tommyrohmann/Steam-Engine/1.5x1 Inch 3 Cylidner/Engine Screenshots and Drawings/IMG_2193.jpg

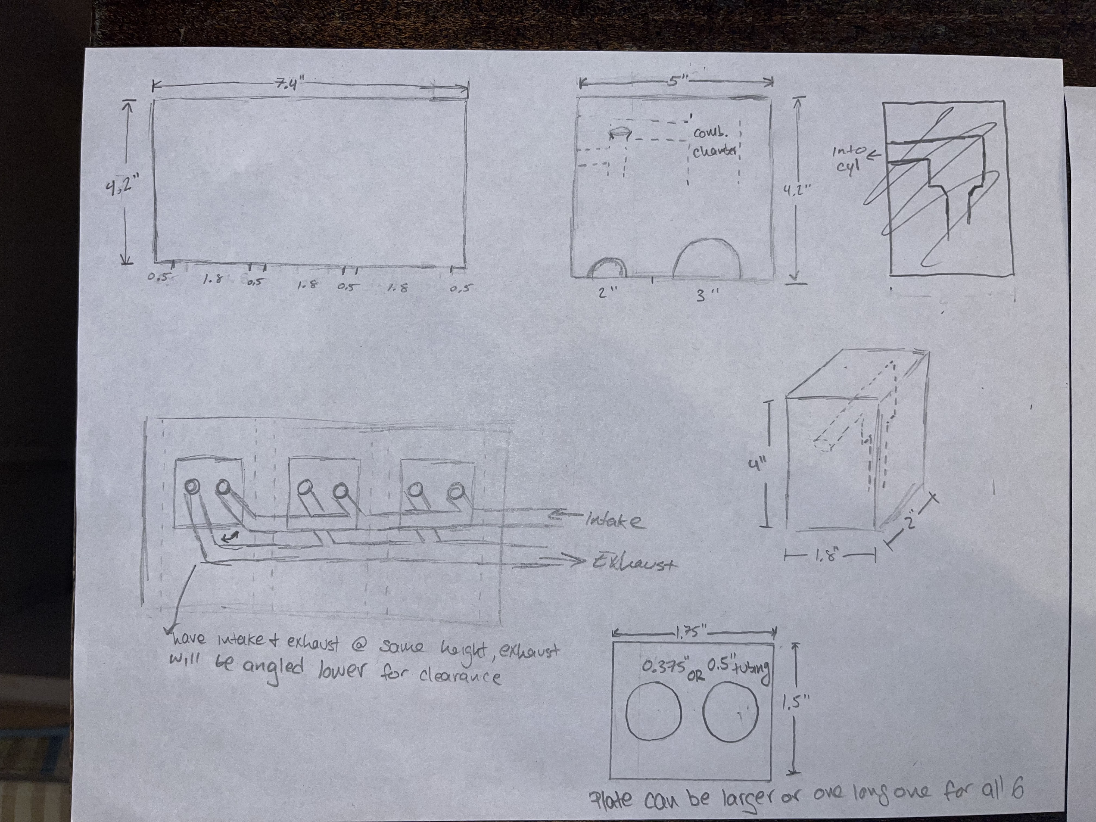
1.5x1 Inch 3 Cylidner/Engine Screenshots and Drawings/IMG_2193.jpg
