tommyrohmann/Steam-Engine/Les Proper Steam Engine/steamboatbookcover_sm.pdf

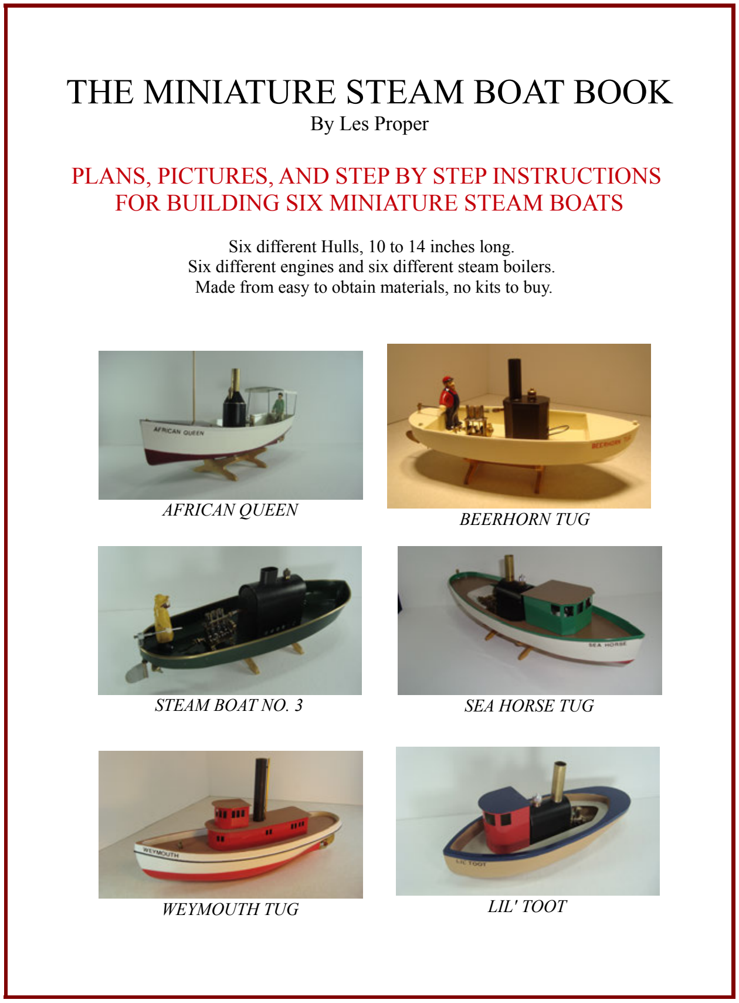
[picture p8: figure]
THE MINIATURE STEAM BOAT BOOK; By Les Proper; FOR BUILDING SIX MINIATURE STEAM BOATS; AFRICAN QUEEN; BEERHORN TUG; LIL' TOOT; STEAM BOAT NO. 3; WEYMOUTH TUG; SEA HORSE TUG

## PLANS, PICTURES, AND STEP BY STEP INSTRUCTIONS

Six different Hulls, 10 to 14 inches long.
Six different engines and six different steam boilers. Made from easy to obtain materials, no kits to buy.

# TABLE OF CONTENTS

PAGE
INTRODUCTION | 1 - 4

SECTION 1 - AFRICAN QUEEN
African Queen Building Instructions | 1 - 21
African Queen Hull and Deck | AQ - 1
Single Cylinder Double Acting Steam Engine | AQ - 2
African Queen Steam Boiler | AQ - 3
African Queen Details | AQ - 4
African Queen Photos | AQ - 5

SECTION 2 - BEERHORN TUG
Beerhorn Tug Building Instructions | 1 - 21
Beerhorn Tug Hull and Deck | BT - 1
Twin Cylinder Single Acting Steam Engine | BT - 2
Beerhorn Tug Steam Boiler | BT - 3&4
Beerhorn Tug Details | BT - 5
Beerhorn Tug Photos | BT - 6

SECTION 3 - STEAM BOAT NO. 3
Steam Boat No. 3 Building Instructions | 1 - 21
Steam Boat No. 3 Hull and Deck | SB3 - 1
Three Cylinder Single Acting Steam Engine | SB3 - 2
Horizontal Boiler No. 1 | SB3 - 3&4
Steam Boat No. 3 Details | SB3 - 5
Steam Boat No. 3 Photos | SB3 - 6

SECTION 4 - SEA HORSE TUG
Sea Horse Tug Building Instructions | 1 - 20
Sea Horse Tug Hull | SHT - 1
V - 4 Cylinder Steam Engine | SHT - 2
Horizontal Boiler No. 2 | SHT - 3&4
Sea Horse Tug Details | SHT - 5&6
Sea Horse Tug Deck and Wheelhouse | SHT - 7
Sea Horse Tug Photos | SHT - 8

SECTION 5 - WEYMOUTH TUG
Weymouth Tug Building Instructions | 1 - 25
Weymouth Tug Hull | WT - 1&2
Weymouth Tug Deck and Superstructure | WT - 3
Twin Cylinder Double Acting Steam Engine | WT - 4
Weymouth Tug Boiler | WT - 5,6&7
Weymouth Tug Details | WT - 8
Weymouth Tug Photos | WT - 9

SECTION 6 - LIL' TOOT TUG
Lil' Toot Tug Building Instructions | 1 - 21
Lil' Toot Tug Hull, Deck, and Wheelhouse | LT - 1
One Cylinder Single Acting Steam Engine | LT - 2
Horizontal Boiler No. 3 | LT - 3&4
Lil' Toot Tug Details | LT - 4
Lil' Toot Tug Photos | LT - 5
