tommyrohmann/Steam-Engine/1.5x1 Inch 3 Cylidner/Engine Screenshots and Drawings/PXL_20230312_021201561.jpg

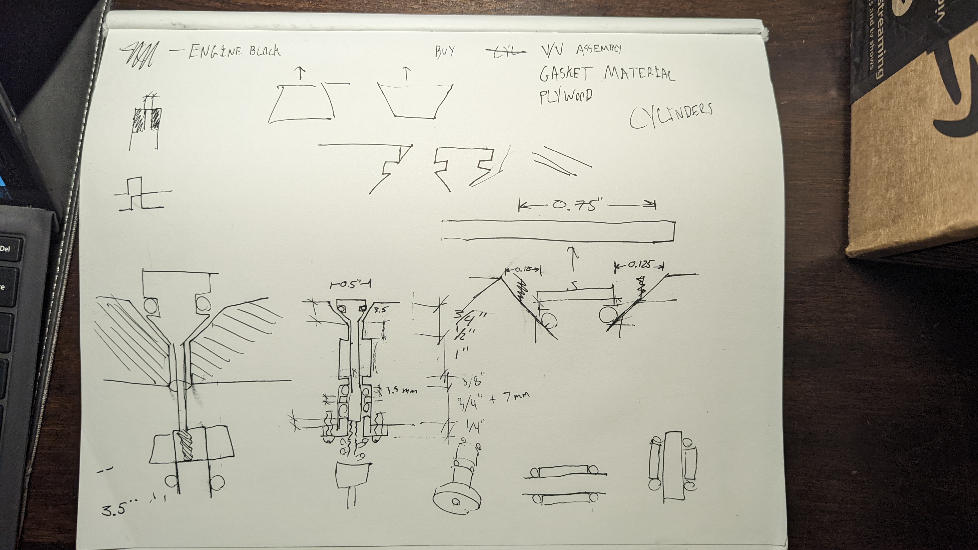
1.5x1 Inch 3 Cylidner/Engine Screenshots and Drawings/PXL_20230312_021201561.jpg
