tommyrohmann/Steam-Engine/Les Proper Steam Engine/Parts List/Les Proper Steam Engine Material List and Cost Analysis.xlsb.xlsx

Sheet: Parts List
Column1 | Column2 | Column3 | Column4
1 | CYLINDER | 9/32" BRASS TUBE
2 | CYLINDER HEAD | FREE CUTTING BRASS ROD
3 | VALVE TUBE | 1/8" BRASS TUBE
4 | BRASS TOP | 0.03" x 1/2" BRASS FLAT BAR
5 | BRASS BASE | 0.03" x 3/4" BRASS FLAT BAR
6 | FRAME POST | 3/32" FREE CUTTING BRASS ROD
7 | INLET MANIFOLD | 3/32" BRASS TUBE
8 | FLYWHEEL | 1/2" FREE CUTTING BRASS ROD
9 | CRANKSHAFT | 5/64" & 3/8" DRILL ROD
10 | 0-80 STAINLESS HEX HEAD AND PHILLIPS HEAD BOLTS
11 | PISTON | FREE CUTTING BRASS ROD | MACHINE TO FIT
12 | VALVE | FREE CUTTING BRASS ROD | MACHINE TO FIT
13 | CONNECTING ROD | 1/32" x 3/32" BRASS FLAT BAR
14 | MAIN BEARING | FREE CUTTING BRASS ROD
15 | VALVE ROD | 1/32" BRASS ROD
16 | ECCENTRIC | 1/4" FREE CUTTING BRASS ROD

Sheet: Sheet1
 | Resource Videos
 | https://www.youtube.com/watch?v=QCbsiK79rfI |  |  | # of Engines | 1 |  |  |  | Retailer: McMaster-Carr |  |  | Cost after shipping and tax
 | https://www.youtube.com/watch?v=bR_tIMWJvpI&list=PLPgGN1PUfGZnEqCRSK7it8fPnHxa9Ix1D |  |  | Length lost due to cutting | 0.125 |  |  |  | Tot. Cost | $206.20 |  | 166.33
 |  |  |  | Safety Factor | 1.1 | 10% |  |  | Cost/Person | $206.20 |  | 166.33
 |  |  |  | Cost Per Person
 |  |  | Component/Machining Chars |  |  | Purchase Chars
# | Component on Engine | Part | len/qty needed per part | # of Parts Needed | QTY Plus Cutting Length and Safety Factor | Len/qty of unit bought | Cost/Unit | QTY to Buy | Cost of Material | Link | Notes
1 | CYLINDER | 9/32" BRASS TUBE | 0.55 | 1 | 0.7425 | 12 | $2.76 | 1 | $2.76 | Ultra-Formable 260 Brass, Round Tube, 1 Foot Long, 0.014" Wall Thickness, 9/32" OD | McMaster-Carr (https://www.mcmaster.com/8859K25/)
2 | CYLINDER HEAD | FREE CUTTING BRASS ROD (Stock) | 0.15 | 1 | 0.3025 | 1 |  | 1 | $0.00
3 | VALVE TUBE | 1/8" ID BRASS TUBE | 0.68 | 1 | 0.8855 | 12 | $2.30 | 1 | $2.30 | https://www.mcmaster.com/8859K21/
4 | BRASS TOP | 0.03" x 1/2" BRASS FLAT BAR | 0.71 | 1 | 0.9185 | 12 | $2.31 | 1 | $2.31 | https://www.mcmaster.com/8859K83/
5 | BRASS BASE | 0.03" x 3/4" BRASS FLAT BAR | 0.71 | 1 | 0.9185 | 12 | $3.37 | 1 | $3.37 | Ultra-Formable 260 Brass, Strip, 3/4" x 12", 0.0320" Thick | McMaster-Carr (https://www.mcmaster.com/8859K84/)
6 | FRAME POST | 3/32" FREE CUTTING BRASS ROD | 0.73 | 4 | 3.762 | 12 | $1.42 | 1 | $1.42 | Ultra-Formable 260 Brass, 1 Foot Long Rod, 3/32" Diameter | McMaster-Carr (https://www.mcmaster.com/8859K52/)
7 | INLET MANIFOLD | 3/32" BRASS TUBE | 0.25 | 1 | 0.4125 | 36 | $3.49 | 1 | $3.49 | https://www.mcmaster.com/8859K18/
8 | FLYWHEEL | 1/2" FREE CUTTING BRASS ROD | 0.21 | 1 | 0.3685 | 1 |  | 1 | $0.00
9 | CRANKSHAFT | 5/64" DRILL ROD | 1 | 1 | 1.2375 | 24 | $36.61 | 1 | $36.61 | Rotary Shaft, 316 Stainless Steel, 5/64" Diameter, 24" Long | McMaster-Carr (https://www.mcmaster.com/1263K28/)
9 | Crankshaft | 3/8" DRILL ROD | 0.12 | 2 | 0.539 | 12 | $6.52 | 1 | $6.52 | Rotary Shaft, 316 Stainless Steel, 5/64" Diameter, 24" Long | McMaster-Carr (https://www.mcmaster.com/1263K28/)
10 | 0-80 STAINLESS HEX HEAD AND PHILLIPS HEAD BOLTS | ASSEMBLY AND SET SCREWS | 1 | 9 | 11.1375 | 100 | $10.67 | 1 | $10.67 | https://www.mcmaster.com/91781A055/
11 | PISTON | FREE CUTTING BRASS ROD | 0.35 | 1 | 0.5225 | 1 | 0 | 1 | $0.00
12 | VALVE | FREE CUTTING BRASS ROD | 0.78 | 1 | 0.9955 | 1 | 0 | 1 | $0.00
13 | CONNECTING ROD | 1/32" x 3/32" BRASS FLAT BAR | 0.82 | 1 | 1.0395 | 12 | $1.32 | 1 | $1.32 | https://www.mcmaster.com/8859K82/
14 | MAIN BEARING | FREE CUTTING BRASS ROD | 0 | 2 | 0.275 | 1 | 0 | 1 | $0.00
15 | VALVE ROD | 1/32" BRASS ROD | 1 | 1 | 1.2375 | 60 | $2.39 | 1 | $2.39 | https://www.mcmaster.com/8859K481/
16 | ECCENTRIC | 1/4" FREE CUTTING BRASS ROD | 0 | 1 | 0.1375 | 1 | 0 | 1 | $0.00
 | SUM LENGTH OF MACHINE BRASS STOCK (HIGHLIGHTED ORANGE) | 1/2" BRASS STOCK | 2.6015 | 1 | 2.99915 | 36 | $38.77 | 1 | $38.77 | Formable Easy-to-Machine 353 Brass Rod, 1/2" Diameter | McMaster-Carr (https://www.mcmaster.com/8313K14/)
 |  | Required Tools
 |  | 0-80 Tap |  |  |  |  | $6.76 | 4 | $27.04 | https://www.mcmaster.com/25995A114/
 |  | Drill Bit Set | 1 |  |  |  | 39.99 | 1 | $39.99 | https://www.amazon.com/gp/product/B07QNPBTKY/ref=ppx_yo_dt_b_asin_title_o04_s00?ie=UTF8&psc=1
 |  | Silver Solder |  |  |  |  |  |  | $0.00 | https://www.amazon.com/Oatay-Plumbing-Solder-solder-flux/dp/B000FK743G
 |  |  |  |  |  |  | 19.75 | 1 | $19.75 | https://www.amazon.com/Oatay-Plumbing-Solder-solder-flux/dp/B000FK743G?s=hi
 |  |  |  |  |  |  |  |  | $0.00 | https://www.amazon.com/gp/product/B07Z41KQ36/ref=sw_img_1?smid=AYAOXGJC4GQOY&psc=1
 |  | 5mm End Mill |  |  |  |  |  |  | $0.00 | https://www.amazon.com/1pc-Flutes-Carbide-Square-Mill/dp/B09VFFDLS7?pid=iKz2KQj&s=industrial
 |  |  |  |  |  |  | 7.49 | 1 | $7.49 | https://www.amazon.com/gp/product/B000936R1O/ref=sw_img_1?smid=ATVPDKIKX0DER&psc=1
