tommyrohmann/Steam-Engine/1.5x1 Inch 3 Cylidner/Steam Engine Purchase 1/Steam Engine Purchase 1.png

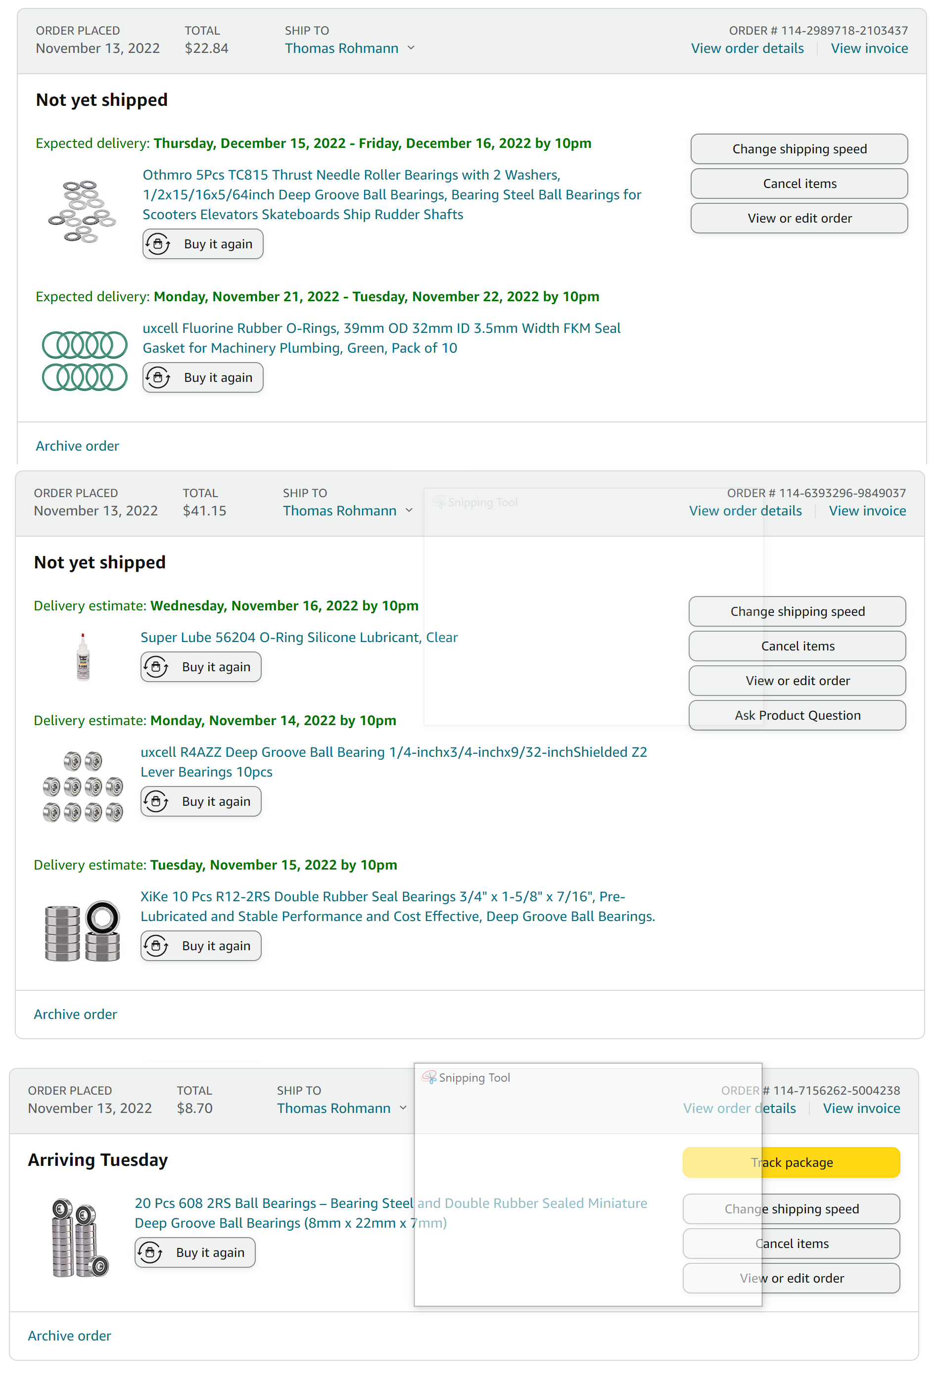
1.5x1 Inch 3 Cylidner/Steam Engine Purchase 1/Steam Engine Purchase 1.png
