tommyrohmann/Steam-Engine/1.5x1 Inch 3 Cylidner/Cast and Assembled V5/Cutting Jigs/C.Crank on Crankshaft Cutting Jig.stl

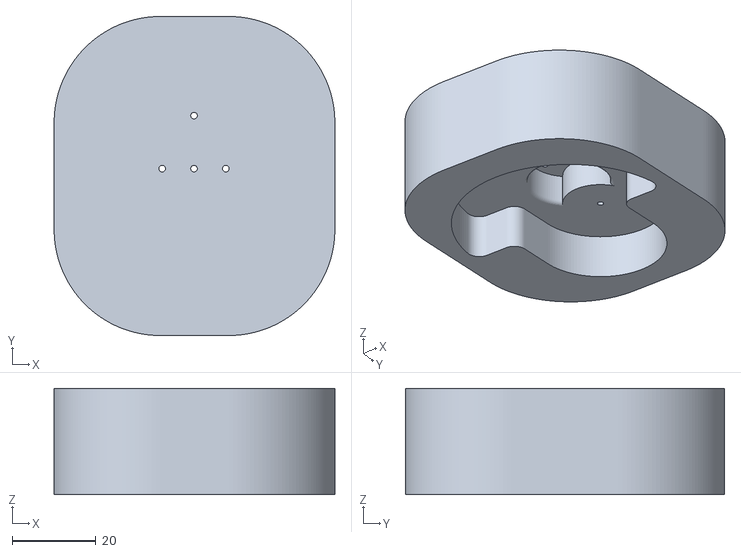
[picture p13: CAD file, 2023-02-10]
1.5x1 Inch 3 Cylidner/Cast and Assembled V5/Cutting Jigs/C.Crank on Crankshaft Cutting Jig.stl
67.2 x 76.4 x 25.4
