tommyrohmann/Steam-Engine/1.5x1 Inch 3 Cylidner/Cast and Assembled V5/STLs for 3d Prints/Piston Head Stock Cast Image.stl

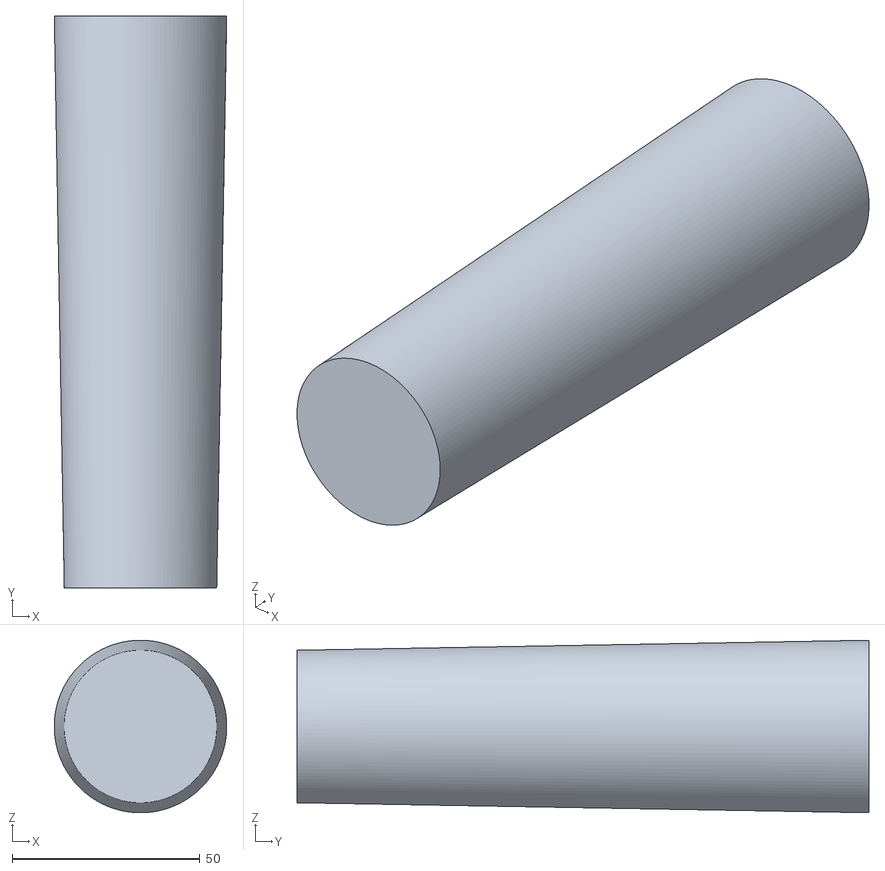
[picture p15: CAD file, 2023-03-14]
1.5x1 Inch 3 Cylidner/Cast and Assembled V5/STLs for 3d Prints/Piston Head Stock Cast Image.stl
46.0 x 152.4 x 46.0
