tommyrohmann/Steam-Engine/Les Proper Steam Engine/CAD/Cutting Jig/Cutting Jig.stl

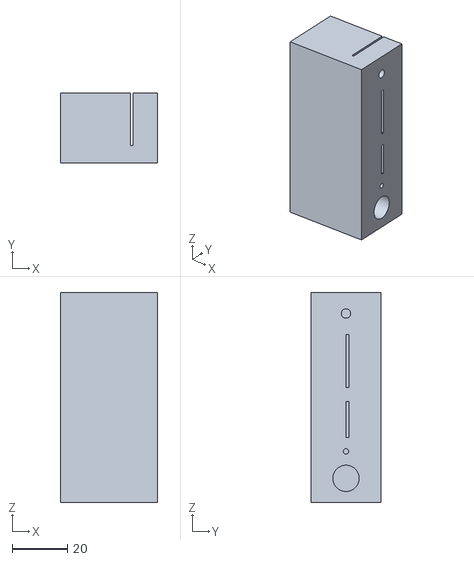
[picture p16: CAD file, 2023-04-16]
Les Proper Steam Engine/CAD/Cutting Jig/Cutting Jig.stl
35.1 x 25.4 x 76.2
