tommyrohmann/Steam-Engine/1.5x1 Inch 3 Cylidner/Cast and Assembled V5/Cutting Jigs/C.Connecting Rod Cutting Jig.stl

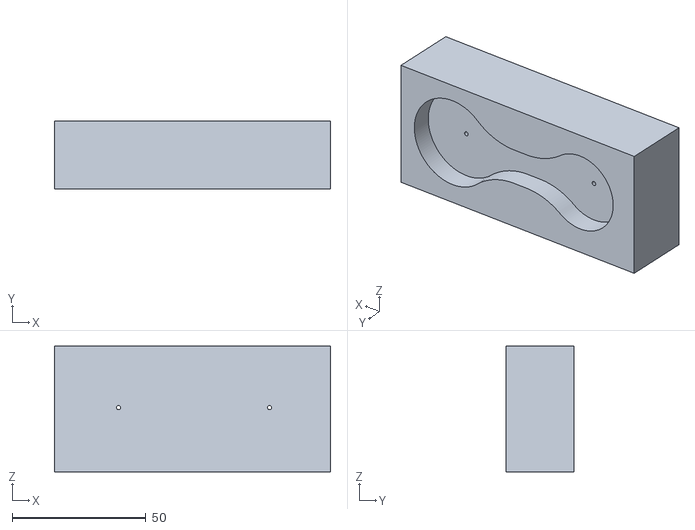
[picture p17: CAD file, 2023-02-09]
1.5x1 Inch 3 Cylidner/Cast and Assembled V5/Cutting Jigs/C.Connecting Rod Cutting Jig.stl
103.3 x 25.4 x 47.1
