tommyrohmann/Steam-Engine/1.5x1 Inch 3 Cylidner/Cast and Assembled V5/Mock up Parts/C.Crank Connect Shaft .44 Inch.stl

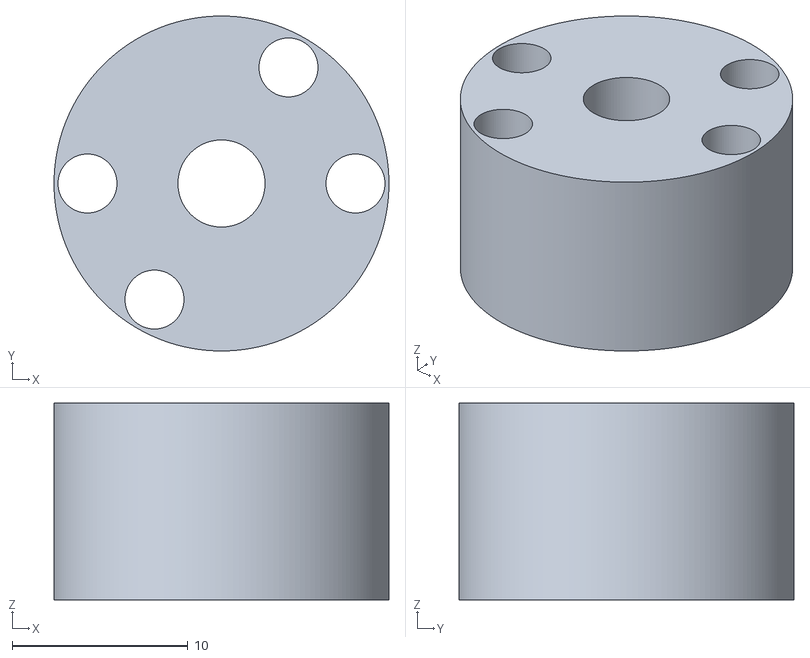
[picture p18: CAD file, 2023-02-17]
1.5x1 Inch 3 Cylidner/Cast and Assembled V5/Mock up Parts/C.Crank Connect Shaft .44 Inch.stl
19.0 x 19.0 x 11.2
