tommyrohmann/Steam-Engine/1.5x1 Inch 3 Cylidner/Cast and Assembled V5/STLs for 3d Prints/Cylinder Block Cast Image.stl

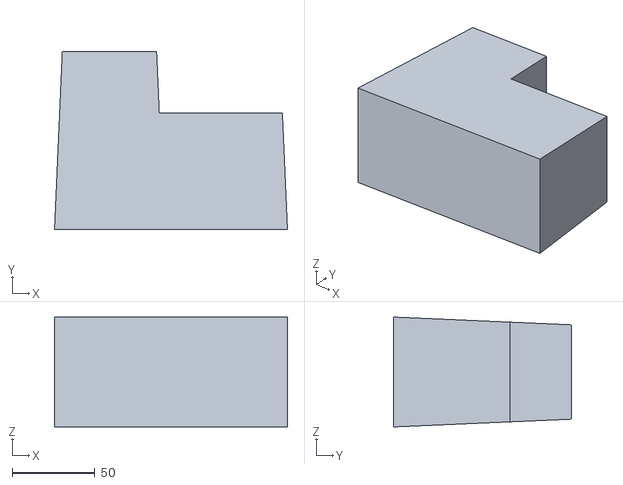
[picture p19: CAD file, 2023-03-14]
1.5x1 Inch 3 Cylidner/Cast and Assembled V5/STLs for 3d Prints/Cylinder Block Cast Image.stl
141.1 x 108.0 x 66.6
