tommyrohmann/Steam-Engine/1.5x1 Inch 3 Cylidner/Cast and Assembled V5/Cutting Jigs/C.Crank Connect Shaft Cutting Jig.stl

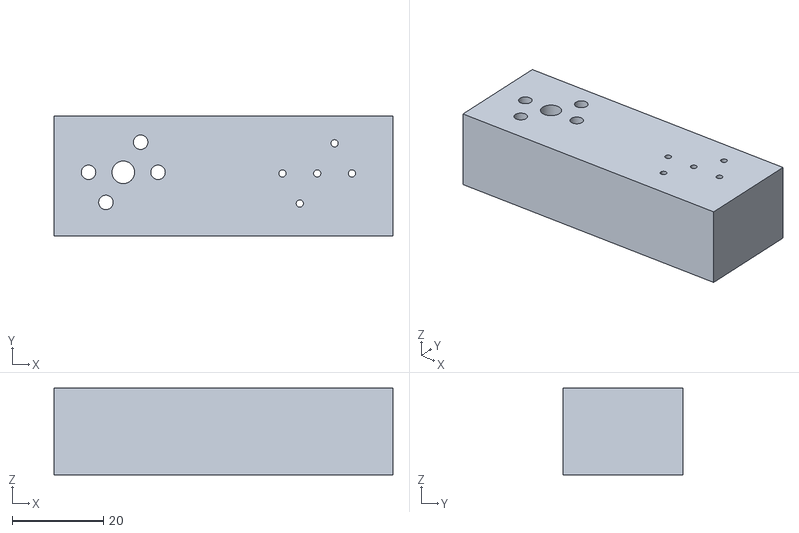
[picture p20: CAD file, 2023-02-09]
1.5x1 Inch 3 Cylidner/Cast and Assembled V5/Cutting Jigs/C.Crank Connect Shaft Cutting Jig.stl
74.3 x 26.3 x 19.0
