tommyrohmann/Steam-Engine/1.5x1 Inch 3 Cylidner/Old/2 inch Design V2/3d Prints/Crank on Crankshaft 2.stl

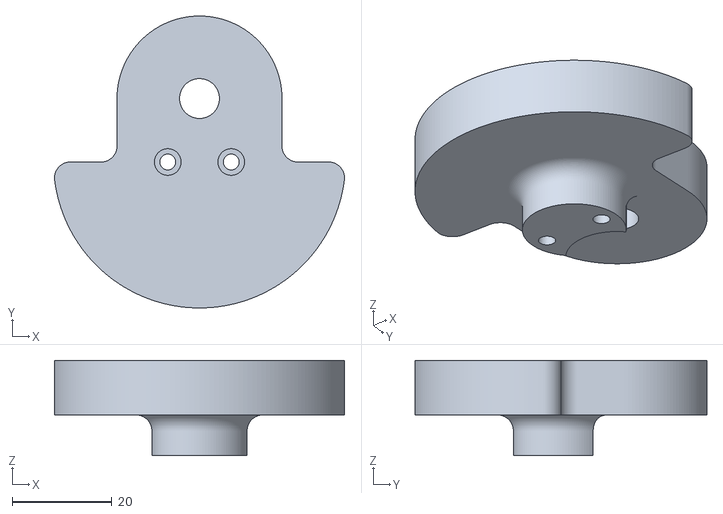
[picture p21: CAD file, 2022-12-22, an earlier design]
1.5x1 Inch 3 Cylidner/Old/2 inch Design V2/3d Prints/Crank on Crankshaft 2.stl
58.0 x 58.4 x 19.0
