tommyrohmann/Steam-Engine/(list of files, cad)

Other CAD files:
Les Proper Steam Engine/Drawings/Engine Assembly Final.dwg
1.5x1 Inch 3 Cylidner/Cast and Assembled V5/CrankShaft Center Cut Drawing.dwg
1.5x1 Inch 3 Cylidner/Cast and Assembled V5/Drawings for Machining/PDFs/C.Crank Connect Shaft.dwg
Les Proper Steam Engine/Drawings/OldVersions/Engine Assembly.0011.dwg
Les Proper Steam Engine/Drawings/OldVersions/Engine Assembly Final.0004.dwg
Les Proper Steam Engine/Drawings/OldVersions/Cylinder Assembly Drawing.0001.dwg
1.5x1 Inch 3 Cylidner/Cast and Assembled V5/Drawings for Machining/PDFs/OldVersions/C.Crank Connect Shaft.0001.dwg
1.5x1 Inch 3 Cylidner/Cast and Assembled V5/OldVersions/CrankShaft Center Cut Drawing.0001.dwg
1.5x1 Inch 3 Cylidner/2 Inch V3/Connecting Rod Bearing.ipt
1.5x1 Inch 3 Cylidner/2 Inch V3/Connecting Rod.iam
1.5x1 Inch 3 Cylidner/2 Inch V3/Crank on Crankshaft.ipt
1.5x1 Inch 3 Cylidner/2 Inch V3/CrankShaft Main Bearing.ipt
1.5x1 Inch 3 Cylidner/2 Inch V3/Crankshaft Subassembly.iam
1.5x1 Inch 3 Cylidner/2 Inch V3/Crankshaft.ipt
1.5x1 Inch 3 Cylidner/2 Inch V3/Frame Sides.ipt
1.5x1 Inch 3 Cylidner/2 Inch V3/Head Cylinder and Frame Subassembly.iam
1.5x1 Inch 3 Cylidner/2 Inch V3/Piston 2.ipt
1.5x1 Inch 3 Cylidner/2 Inch V3/Piston Subassembly.iam
1.5x1 Inch 3 Cylidner/Cast and Assembled V5/A.Crankshaft Subassembly.iam
1.5x1 Inch 3 Cylidner/Cast and Assembled V5/A.Piston Subassembly.iam
1.5x1 Inch 3 Cylidner/Cast and Assembled V5/C.Connecting Rod Bearing.ipt
1.5x1 Inch 3 Cylidner/Cast and Assembled V5/C.Connecting Rod.ipt
1.5x1 Inch 3 Cylidner/Cast and Assembled V5/C.Crank Connect Shaft.ipt
1.5x1 Inch 3 Cylidner/Cast and Assembled V5/C.Crank on Crankshaft.ipt
1.5x1 Inch 3 Cylidner/Cast and Assembled V5/C.Crankshaft Main Bearing.ipt
1.5x1 Inch 3 Cylidner/Cast and Assembled V5/Cast Images/C.Crank on Crankshaft Cast Image.ipt
1.5x1 Inch 3 Cylidner/Cast and Assembled V5/Cast Images/Connecting Rod Cast Image.ipt
1.5x1 Inch 3 Cylidner/Cast and Assembled V5/Cast Images/Cylinder Block Cast Image.ipt
1.5x1 Inch 3 Cylidner/Cast and Assembled V5/Cast Images/OldVersions/C.Crank on Crankshaft Cast Image.0001.ipt
1.5x1 Inch 3 Cylidner/Cast and Assembled V5/Cast Images/OldVersions/E.Engine Block Bottom Cast Image Left.0001.ipt
1.5x1 Inch 3 Cylidner/Cast and Assembled V5/Cast Images/OldVersions/E.Engine Block Bottom Cast Image Right.0001.ipt
1.5x1 Inch 3 Cylidner/Cast and Assembled V5/Cast Images/OldVersions/E.Engine Block Bottom Cast Image.0001.ipt
1.5x1 Inch 3 Cylidner/Cast and Assembled V5/Cast Images/OldVersions/E.Engine Block Top Cast Image Right.0001.ipt
1.5x1 Inch 3 Cylidner/Cast and Assembled V5/Cast Images/OldVersions/E.Engine Block Top Cast Image.0001.ipt
1.5x1 Inch 3 Cylidner/Cast and Assembled V5/Cast Images/Piston Head Stock Cast Image.ipt
1.5x1 Inch 3 Cylidner/Cast and Assembled V5/Cutting Jigs/C.Connecting Rod Cutting Jig.ipt
1.5x1 Inch 3 Cylidner/Cast and Assembled V5/Cutting Jigs/C.Crank Connect Shaft Cutting Jig.ipt
1.5x1 Inch 3 Cylidner/Cast and Assembled V5/Cutting Jigs/C.Crank on Crankshaft Cutting Jig 2.ipt
1.5x1 Inch 3 Cylidner/Cast and Assembled V5/Cutting Jigs/C.Crank on Crankshaft Cutting Jig.dwg
1.5x1 Inch 3 Cylidner/Cast and Assembled V5/Cutting Jigs/C.Crank on Crankshaft Cutting Jig.ipt
1.5x1 Inch 3 Cylidner/Cast and Assembled V5/Cutting Jigs/OldVersions/C.Connecting Rod Cutting Jig.0001.ipt
1.5x1 Inch 3 Cylidner/Cast and Assembled V5/Cutting Jigs/OldVersions/C.Crank Connect Shaft Cutting Jig.0001.ipt
1.5x1 Inch 3 Cylidner/Cast and Assembled V5/Cutting Jigs/OldVersions/C.Crank on Crankshaft Cutting Jig.0004.ipt
1.5x1 Inch 3 Cylidner/Cast and Assembled V5/E.Bearing Holder Top.ipt
1.5x1 Inch 3 Cylidner/Cast and Assembled V5/E.Cylinder Block.ipt
1.5x1 Inch 3 Cylidner/Cast and Assembled V5/E.Engine Head Gasket.ipt
1.5x1 Inch 3 Cylidner/Cast and Assembled V5/E.Engine Head Top.ipt
1.5x1 Inch 3 Cylidner/Cast and Assembled V5/Engine Assembly.iam
1.5x1 Inch 3 Cylidner/Cast and Assembled V5/OldVersions/A.Piston Subassembly.0001.iam
1.5x1 Inch 3 Cylidner/Cast and Assembled V5/OldVersions/C.Connecting Rod Bearing.0002.ipt
1.5x1 Inch 3 Cylidner/Cast and Assembled V5/OldVersions/C.Connecting Rod.0005.ipt
1.5x1 Inch 3 Cylidner/Cast and Assembled V5/OldVersions/C.Crank Connect Shaft.0013.ipt
1.5x1 Inch 3 Cylidner/Cast and Assembled V5/OldVersions/C.Crank on Crankshaft.0011.ipt
1.5x1 Inch 3 Cylidner/Cast and Assembled V5/OldVersions/C.Crankshaft Main Bearing.0002.ipt
1.5x1 Inch 3 Cylidner/Cast and Assembled V5/OldVersions/Cam Shaft Test.0002.ipt
1.5x1 Inch 3 Cylidner/Cast and Assembled V5/OldVersions/Camshaft Bearing.0001.ipt
1.5x1 Inch 3 Cylidner/Cast and Assembled V5/OldVersions/Connecting Rod Bearing.0001.ipt
1.5x1 Inch 3 Cylidner/Cast and Assembled V5/OldVersions/Connecting Rod Cast Image.0001.ipt
1.5x1 Inch 3 Cylidner/Cast and Assembled V5/OldVersions/Connecting Rod.0001.iam
1.5x1 Inch 3 Cylidner/Cast and Assembled V5/OldVersions/Connecting Rod.0004.ipt
1.5x1 Inch 3 Cylidner/Cast and Assembled V5/OldVersions/Cotter Pin.0004.ipt
1.5x1 Inch 3 Cylidner/Cast and Assembled V5/OldVersions/Crank on Crankshaft 2.0004.ipt
1.5x1 Inch 3 Cylidner/Cast and Assembled V5/OldVersions/Crank on Crankshaft.0007.ipt
1.5x1 Inch 3 Cylidner/Cast and Assembled V5/OldVersions/CrankShaft Main Bearing.0001.ipt
1.5x1 Inch 3 Cylidner/Cast and Assembled V5/OldVersions/Crankshaft Subassembly.0002.iam
1.5x1 Inch 3 Cylidner/Cast and Assembled V5/OldVersions/Crankshaft.0004.ipt
1.5x1 Inch 3 Cylidner/Cast and Assembled V5/OldVersions/E.Cylinder Block.0001.ipt
1.5x1 Inch 3 Cylidner/Cast and Assembled V5/OldVersions/E.Engine Block Bottom.0001.ipt
1.5x1 Inch 3 Cylidner/Cast and Assembled V5/OldVersions/E.Engine Block Top.0002.ipt
1.5x1 Inch 3 Cylidner/Cast and Assembled V5/OldVersions/Engine Assembly.0005.iam
1.5x1 Inch 3 Cylidner/Cast and Assembled V5/OldVersions/Engine Assembly.0007.iam
1.5x1 Inch 3 Cylidner/Cast and Assembled V5/OldVersions/Engine Head Bottom.0004.ipt
1.5x1 Inch 3 Cylidner/Cast and Assembled V5/OldVersions/Engine Head Gasket.0002.ipt
1.5x1 Inch 3 Cylidner/Cast and Assembled V5/OldVersions/Engine Head Top.0002.ipt
1.5x1 Inch 3 Cylidner/Cast and Assembled V5/OldVersions/Frame L Branket Opposite Side.0001.ipt
1.5x1 Inch 3 Cylidner/Cast and Assembled V5/OldVersions/Frame L Branket.0005.ipt
1.5x1 Inch 3 Cylidner/Cast and Assembled V5/OldVersions/Frame Sides.0004.ipt
1.5x1 Inch 3 Cylidner/Cast and Assembled V5/OldVersions/Head Cylinder and Frame Subassembly.0004.iam
1.5x1 Inch 3 Cylidner/Cast and Assembled V5/OldVersions/Piston 2.0002.ipt
1.5x1 Inch 3 Cylidner/Cast and Assembled V5/OldVersions/Test for new Cast Assembly.0001.iam
1.5x1 Inch 3 Cylidner/Cast and Assembled V5/OldVersions/Valve Test.0001.ipt
1.5x1 Inch 3 Cylidner/Cast and Assembled V5/OldVersions/Wrist Pin Bearing.0002.ipt
1.5x1 Inch 3 Cylidner/Cast and Assembled V5/OldVersions/Wrist Pin.0006.ipt
1.5x1 Inch 3 Cylidner/Cast and Assembled V5/P.Cotter Pin.ipt
1.5x1 Inch 3 Cylidner/Cast and Assembled V5/P.Piston O Ring.ipt
1.5x1 Inch 3 Cylidner/Cast and Assembled V5/P.Piston.ipt
1.5x1 Inch 3 Cylidner/Cast and Assembled V5/P.Wrist Pin Bearing.ipt
1.5x1 Inch 3 Cylidner/Cast and Assembled V5/P.Wrist Pin.ipt
1.5x1 Inch 3 Cylidner/Cast and Assembled V5/T.Camshaft Bearing.ipt
1.5x1 Inch 3 Cylidner/Old/2 Inch V3/Connecting Rod.iam
1.5x1 Inch 3 Cylidner/Old/2 Inch V3/Crank on Crankshaft.ipt
1.5x1 Inch 3 Cylidner/Old/2 Inch V3/Crankshaft Subassembly.iam
1.5x1 Inch 3 Cylidner/Old/2 Inch V3/Crankshaft.ipt
1.5x1 Inch 3 Cylidner/Old/2 Inch V3/Head Cylinder and Frame Subassembly.iam
1.5x1 Inch 3 Cylidner/Old/2 Inch V3/OldVersions/Frame Sides.0003.ipt
1.5x1 Inch 3 Cylidner/Old/2 Inch V3/OldVersions/Piston 2.0001.ipt
1.5x1 Inch 3 Cylidner/Old/2 Inch V3/To Be Updated/OldVersions/Cylinder Bracket.0003.ipt
1.5x1 Inch 3 Cylidner/Old/2 Inch V3/To Be Updated/OldVersions/Cylinders.0007.ipt
1.5x1 Inch 3 Cylidner/Old/2 inch Design V2/3D Prints for Molds/Piston Mold.ipt
1.5x1 Inch 3 Cylidner/Old/2 inch Design V2/3d Prints/Connecting Rod.stl
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
