tommyrohmann/Steam-Engine/1.5x1 Inch 3 Cylidner/Engine Screenshots and Drawings/Steam Construction Rough Drawing.PNG

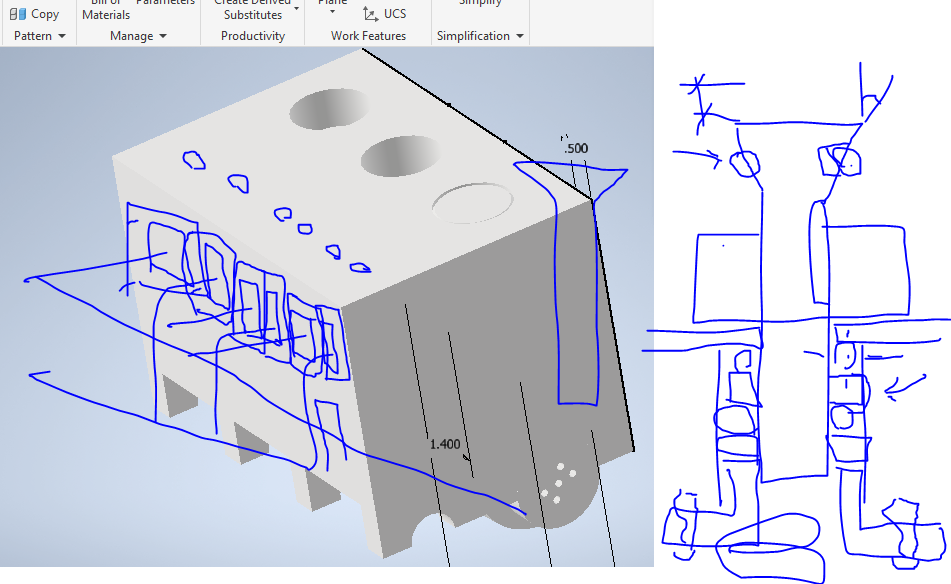
1.5x1 Inch 3 Cylidner/Engine Screenshots and Drawings/Steam Construction Rough Drawing.PNG
