tommyrohmann/Steam-Engine/1.5x1 Inch 3 Cylidner/Cast and Assembled V5/CrankShaft Center Cut Drawing.pdf

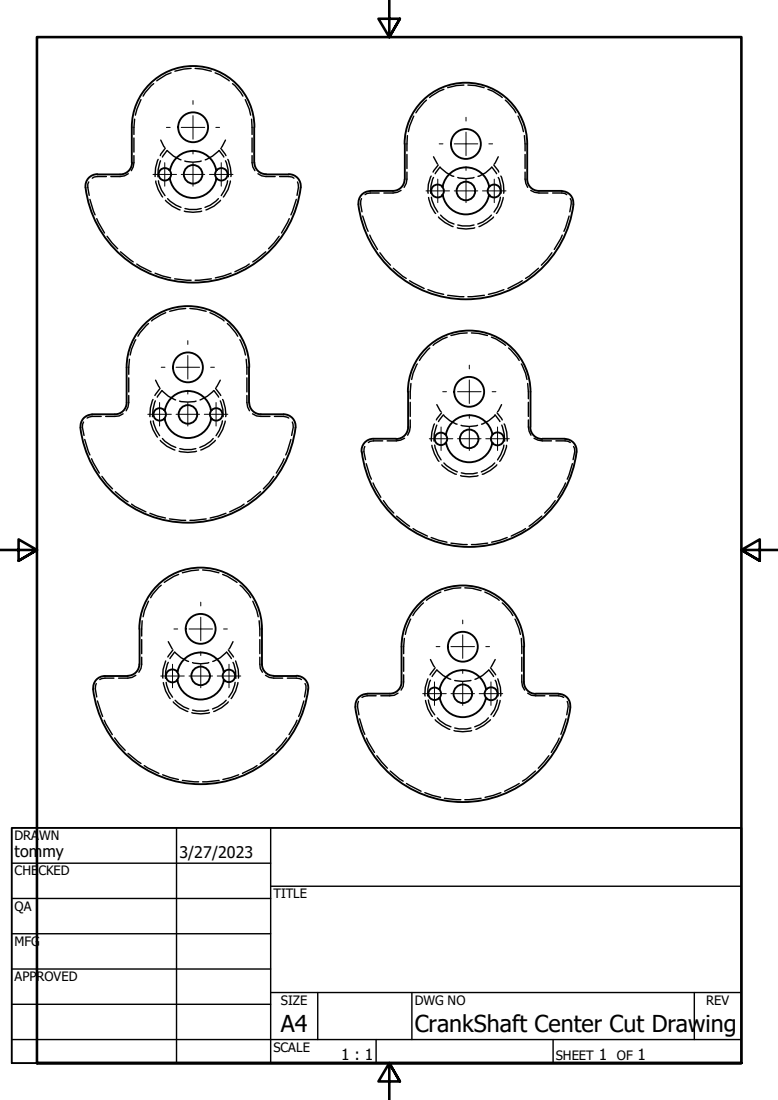
[picture p46: page 1]

DRAWN tommy | 3/27/2023

CHECKED

MFG

APPROVED

SIZE A4 | DWG NO CrankShaft Center Cut Drawing | REV

SCALE 1 : 1 | SHEET 1 OF 1
