tommyrohmann/Steam-Engine/1.5x1 Inch 3 Cylidner/Cast and Assembled V5/Drawings for Machining/PDFs/C.Crank Connect Shaft with Cut Template.pdf

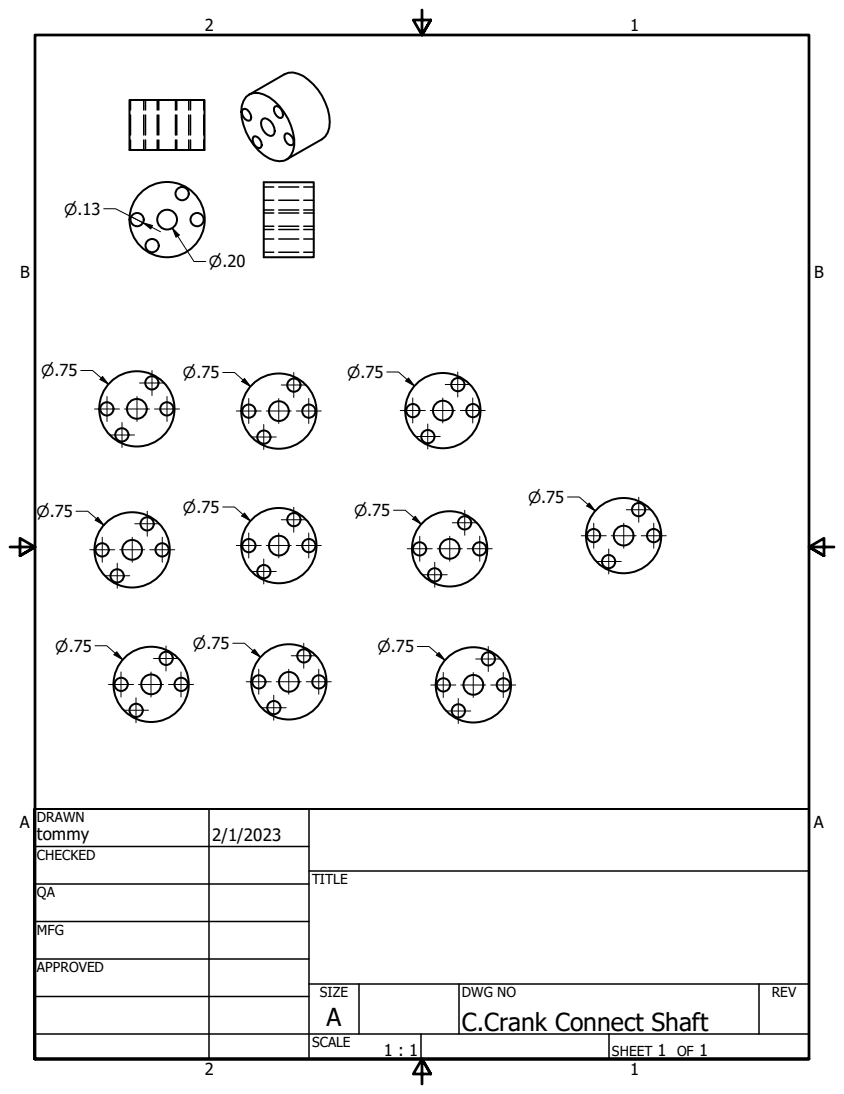
[picture p47: page 1]

DRAWN tommy | 2/1/2023

CHECKED

MFG

APPROVED

SIZE A | DWG NO C.Crank Connect Shaft | REV

SCALE 1 : 1 | | SHEET 1 OF 1
