tommyrohmann/Steam-Engine/Les Proper Steam Engine/verticalboiler3B.pdf

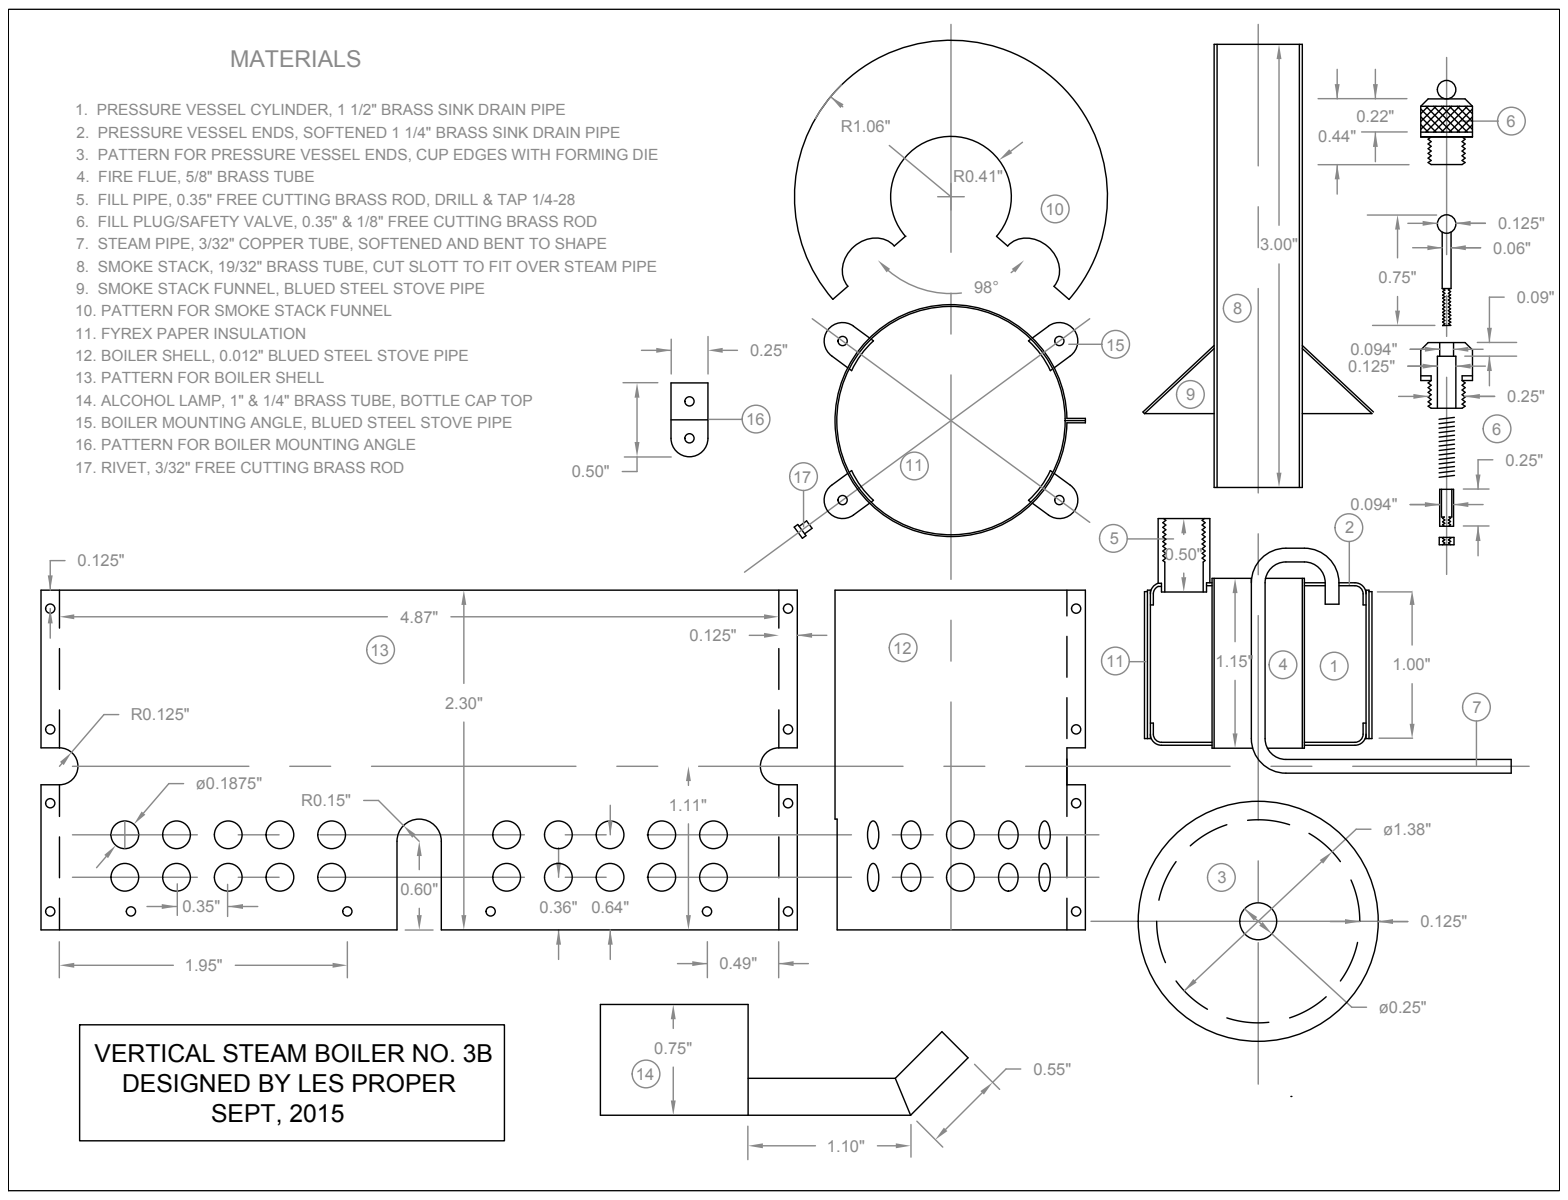
[picture p48: page 1]
VERTICAL STEAM BOILER NO.; PRESSURE VESSEL CYLINDER,; BRASS SINK DRAIN PIPE; PRESSURE VESSEL ENDS,; SOFTENED 1 1/4"; PATTERN FOR PRESSURE VESSEL ENDS,; CUP EDGES WITH FORMING DIE; FIRE FLUE,; BRASS TUBE; FILL PIPE,; FREE CUTTING BRASS ROD,; DRILL & TAP 1/4-28; FILL PLUG/SAFETY VALVE,; FREE CUTTING BRASS ROD; STEAM PIPE,; COPPER TUBE,; SOFTENED AND BENT TO SHAPE; SMOKE STACK,; BRASS TUBE,; CUT SLOTT TO FIT OVER STEAM PIPE; SMOKE STACK FUNNEL,; BLUED STEEL STOVE PIPE; BOILER SHELL,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

10. PATTERN FOR SMOKE STACK FUNNEL

11. FYREX PAPER INSULATION

13. PATTERN FOR BOILER SHELL

16. PATTERN FOR BOILER MOUNTING ANGLE

DESIGNED BY LES PROPER
