tommyrohmann/Steam-Engine/1.5x1 Inch 3 Cylidner/Cast and Assembled V5/P.Piston.pdf

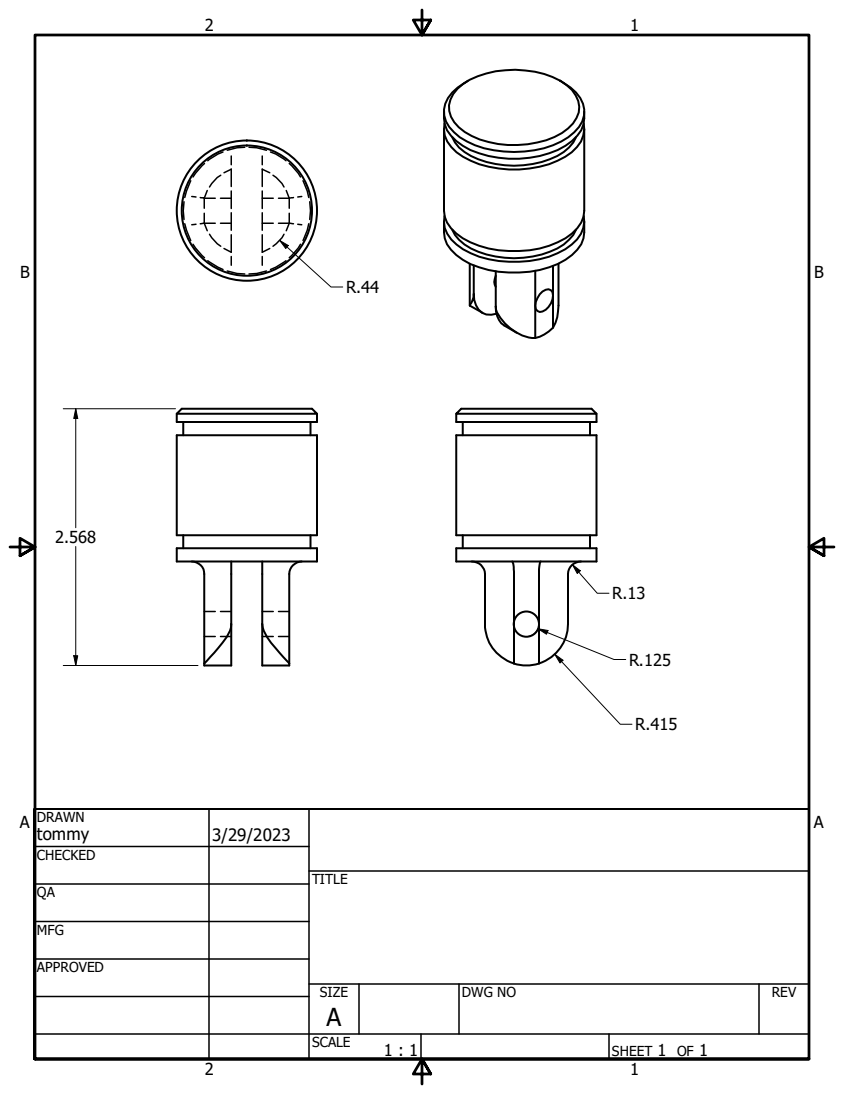
[picture p49: page 1]

DRAWN tommy | 3/29/2023

CHECKED

MFG

APPROVED

SIZE A | DWG NO | REV

SCALE 1 : 1 | | SHEET 1 OF 1
