tommyrohmann/Steam-Engine/(commit log)

2022-12-22 Initial Add
    [91251A128_Black-Oxide Alloy Steel Socket Head Screw.STEP, Bracket.ipt, Connecting Rod Bearing.ipt, Connecting Rod.0002.ipt, Connecting Rod.0004.ipt, Connecting Rod.0005.ipt, Connecting Rod.ipt, Connecting Rod.stl]
2022-12-25 Engine Mock-Up Fully Constrained
    [Crankshaft Subassembly.0002.iam, Crankshaft Subassembly.iam, Crankshaft.0002.ipt, Crankshaft.0003.ipt, Crankshaft.ipt, Engine Assembly.0001.iam, Engine Assembly.0004.iam, Engine Assembly.iam]
2022-12-25 Update With Notes
    Completed mock-up without valve assembly.
    Notes/Things to Change:
    1) Piston needs to be longer to avoid buckling/locking up when experiencing horizontal loads from crankshaft. This will make the cylinder liner longer and therefore the engine taller.
    2) Engine frame/head needs to be larger to accommodate bolt holes and for ease of construction. More room may be needed for valve assembly, which would also alter the frame size.
    3) The plan was to have frame, cylinder, and head to be assembled from off-the-shelf components, but it may make more sense to cast some of these. If moving to cast engine block, frame, head, and cylinder design should be altered. This assembly is ma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
    [Cam Shaft Test.0002.ipt, Cam Shaft Test.ipt, Camshaft Bearing.0001.ipt, Camshaft Bearing.ipt, Connecting Rod Bearing.0001.ipt, Connecting Rod Bearing.ipt, Connecting Rod.0001.iam, Connecting Rod.0003.ipt]
2023-01-04 Updated for Cast Assembly
    Made changes described in previous commit:
    Longer piston heads, adjusted valve assembly space, ect.
    Made engine block and casting image not including valve assembly. Engine to be cast before valve assembly designed. Design will now be made to fit parameters of cast.
    [A.Crankshaft Subassembly.0001.iam, A.Crankshaft Subassembly.iam, A.Piston Subassembly.0001.iam, A.Piston Subassembly.iam, C.Connecting Rod Bearing.0002.ipt, C.Connecting Rod Bearing.ipt, C.Connecting Rod.ipt, C.Crank Connect Shaft.0007.ipt]
2023-01-05 added drawings and stuff
    [E.Engine Block Bottom.0001.ipt, E.Engine Block Bottom.ipt, E.Engine Block Top Cast Image Right.0001.ipt, E.Engine Block Top Cast Image Right.ipt, E.Engine Block Top.0001.ipt, E.Engine Block Top.0002.ipt, E.Engine Block Top.ipt, Engine Assembly.0001.iam]
2023-02-27 Update Les Proper Steam Engine Material List and Cost Analysis.xlsx
    [Les Proper Steam Engine Material List and Cost Analysis.xlsx]
2023-03-02 Order Finally
    [Les Proper Steam Engine Material List and Cost Analysis.xlsx]
2023-03-09 Added Valve Drawings
2023-03-27 Added Cutting Guide
    [CrankShaft Center Cut Drawing.dwg, E.Bearing Holder Top.ipt, Engine Assembly.0005.iam, Engine Assembly.0006.iam, Engine Assembly.iam]
2023-08-24 Final Updates for Leslie Proper Steam Engine
    [Cylinder Assembly Drawing.dwg, Engine Assembly Final.0003.dwg, Engine Assembly Final.dwg, Engine Assembly.0003.dwg, Engine Assembly.0006.iam, Engine Assembly.0007_1.iam, Engine Assembly.0011.dwg, Engine Assembly.0011.iam]
